jmarndt/Cryptex/Design Files/Housing.stl

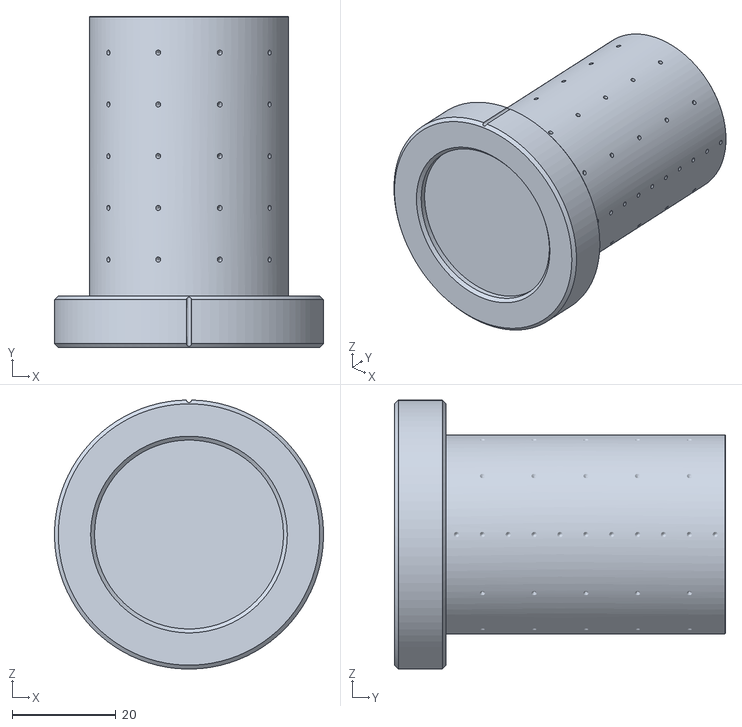
[picture p1: CAD file, 2018-02-15]
Design Files/Housing.stl
52.0 x 64.0 x 52.0
