jmarndt/Cryptex/Design Files/Ring.stl

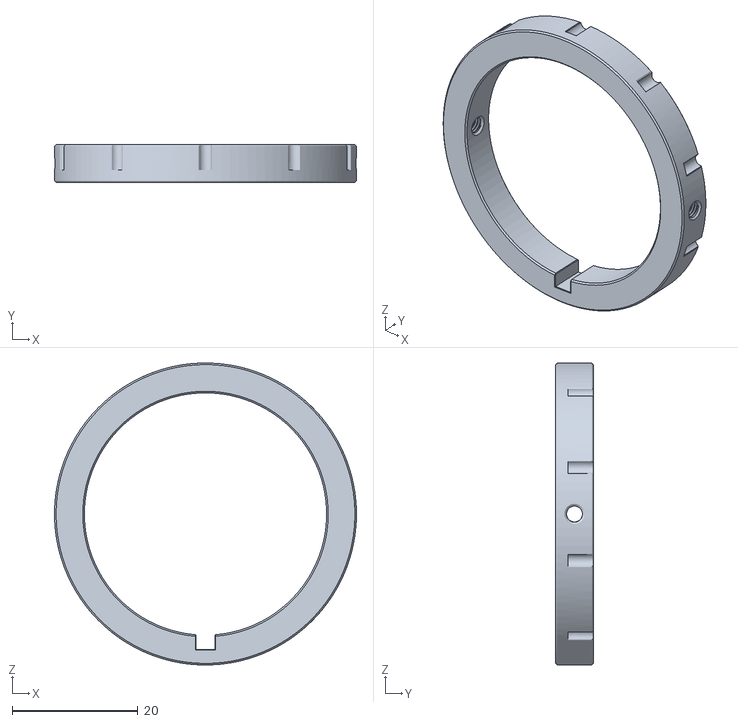
[picture p2: CAD file, 2018-02-15]
Design Files/Ring.stl
48.0 x 6.00 x 48.0
