jmarndt/Cryptex/Design Files/Code Sleeve.stl

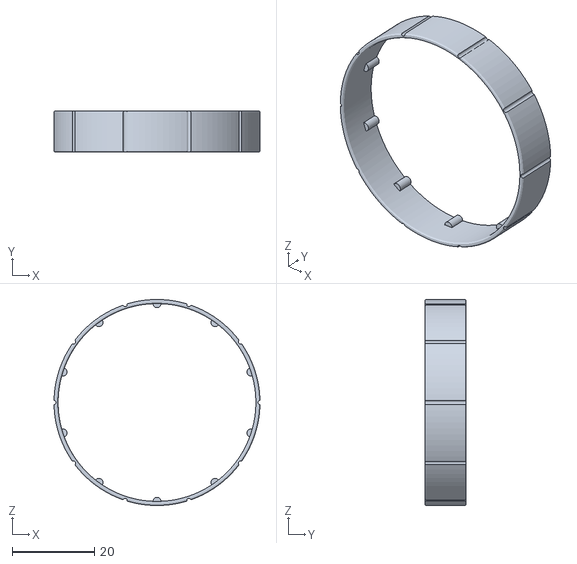
[picture p3: CAD file, 2018-02-15]
Design Files/Code Sleeve.stl
50.0 x 10.00 x 50.0
