jmarndt/Cryptex/Design Files/Spacer.stl

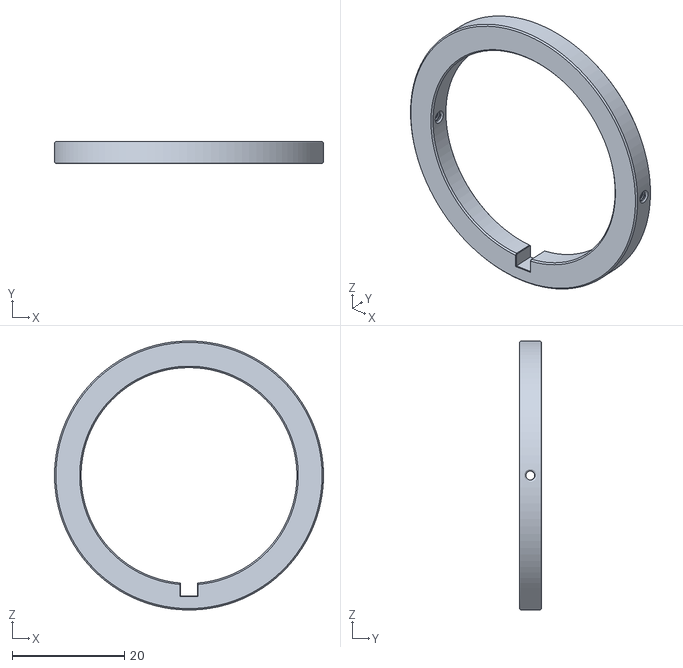
[picture p4: CAD file, 2018-02-15]
Design Files/Spacer.stl
48.0 x 4.00 x 48.0
