jmarndt/Cryptex/Design Files/Core.stl

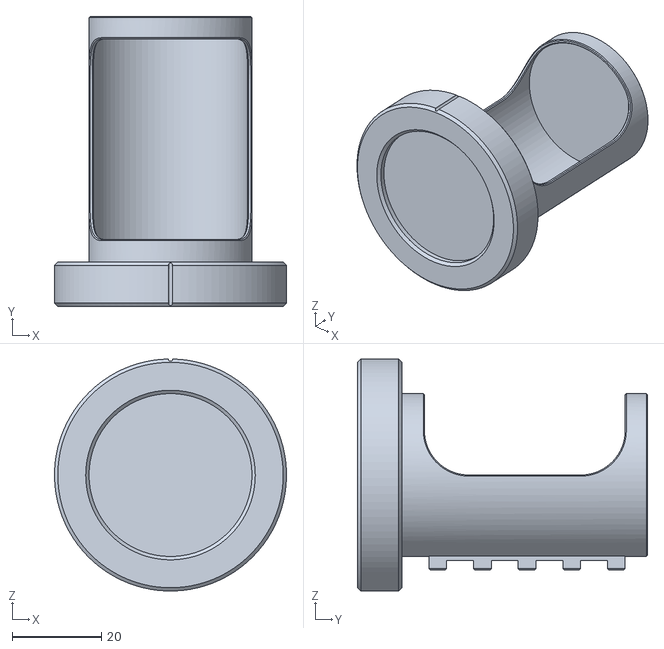
[picture p5: CAD file, 2018-02-15]
Design Files/Core.stl
52.0 x 65.0 x 52.0
